stevenpi140/-/docs/acrylic/front-acrylic.png

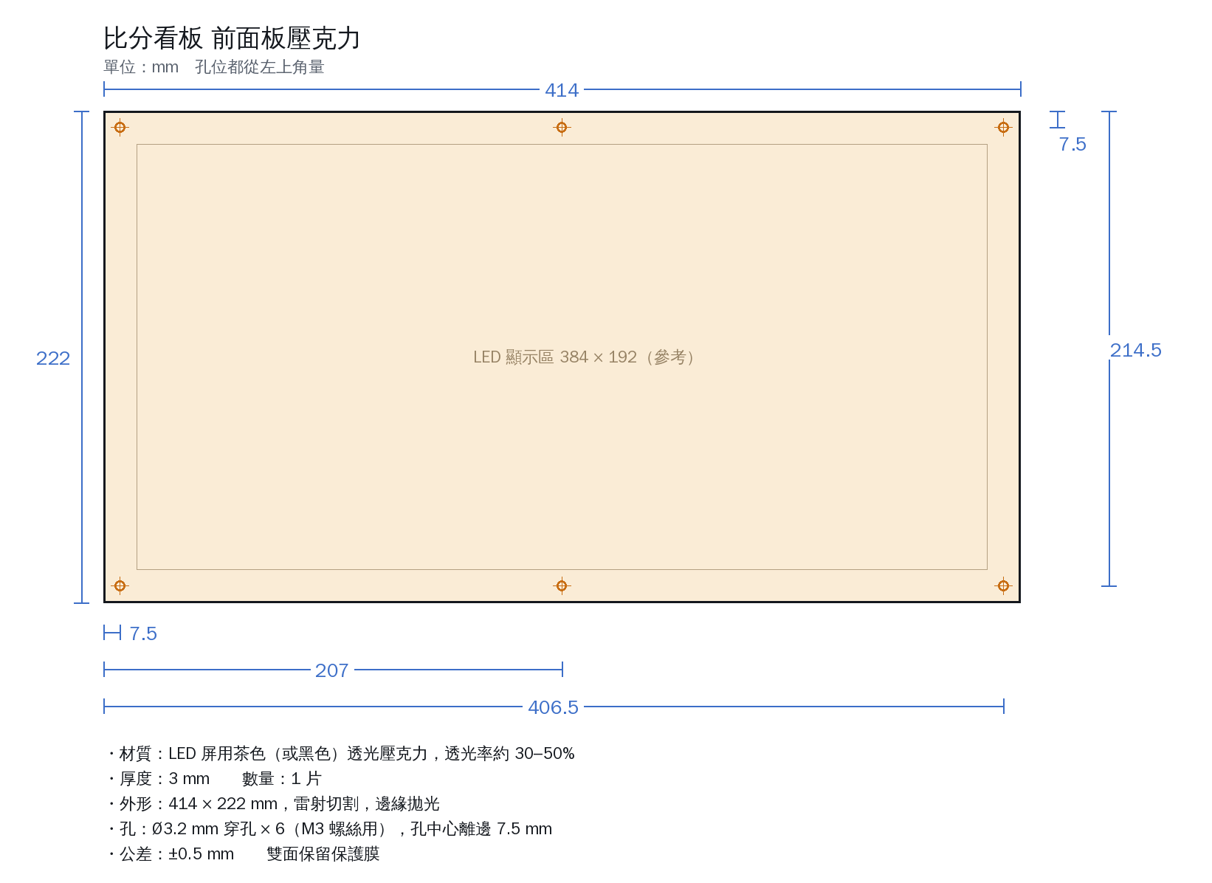
docs/acrylic/front-acrylic.png
