stevenpi140/-/(list of files, cad)

Other CAD files:
docs/acrylic/front-acrylic.dxf
