stevenpi140/-/firmware/include/es8311.h

// ES8311 音訊晶片驅動，取自微雪 ESP32-S3-RGB-Matrix 範例 09_Music_Player
// https://github.com/waveshareteam/ESP32-S3-RGB-Matrix （Apache License 2.0）
#pragma once

#include <Arduino.h>
#include <Wire.h>

#define ES8311_ADDR              0x18
#define ES8311_SAMPLE_RATE48     48000
#define ES8311_BITS_PER_SAMPLE16 16

struct coeff_div_t {
  uint32_t mclk;
  uint32_t rate;
  uint8_t pre_div;
  uint8_t pre_multi;
  uint8_t adc_div;
  uint8_t dac_div;
  uint8_t fs_mode;
  uint8_t lrck_h;
  uint8_t lrck_l;
  uint8_t bclk_div;
  uint8_t adc_osr;
  uint8_t dac_osr;
};

class ES8311 {
public:
  explicit ES8311(TwoWire *wire_instance = &Wire);
  ~ES8311();

  bool begin(int32_t sda, int32_t scl, uint32_t frequency);
  bool setVolume(uint8_t volume);
  uint8_t getVolume();
  bool setSampleRate(uint32_t sample_rate);
  bool setBitsPerSample(uint8_t bps);
  bool enableMicrophone(bool enable);
  bool setMicrophoneGain(uint8_t gain);
  uint8_t getMicrophoneGain();
  void read_all();

protected:
  int get_coeff(uint32_t mclk, uint32_t rate);
  bool WriteReg(uint8_t reg, uint8_t val);
  uint8_t ReadReg(uint8_t reg);

private:
  TwoWire *_wire = nullptr;
  uint32_t _mclk_hz = 48000 * 256;
};
