stevenpi140/-/(commit log)

2026-10-26 點陣比分看板：伺服器（五聯盟資料＋點陣渲染）與 ESP32 HUB75 韌體
    - server/: 抓取 CPBL、MLB、NBA、TPBL、PLG 今日賽事，依追蹤清單篩選，
    渲染成 128x64 RGB565 畫面給 ESP32；含預覽、probe 除錯指令與測試
    - firmware/: PlatformIO 專案（MatrixPortal S3 / 一般 ESP32），
    WiFiManager 設定、雙緩衝顯示、按鍵換頁／暫停
    - README: 硬體清單、接線、安裝與疑難排解
    Claude-Session: https://claude.ai/code/session_016gQEbBCiwzjvZz93CgmEKp
2026-10-26 硬體改推薦 ESP32 Trinity，韌體加入 trinity env 與單緩衝備援
    - 函式庫作者表示 MatrixPortal S3 搭配此函式庫可能有 WiFi 干擾，改推薦 Trinity
    - README 硬體清單補上查到的價格、面板驅動晶片相容清單、E 腳說明
    - 一般 ESP32 記憶體不足以雙緩衝時自動改單緩衝，並移除多餘的 16KB 畫面暫存
    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
2026-10-26 新增淘寶硬體組合：微雪 ESP32-S3-RGB-Matrix 驅動板與韌體 env
    - 韌體新增 waveshare_s3 env（ESP32-S3-WROOM-2 N32R16V，opi 記憶體設定），
    HUB75 腳位依微雪文件，E 腳 GPIO 9
    - README 加入淘寶可購買的組合、搜尋關鍵字與選購注意事項
    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
2026-10-26 依季節自動切換籃球／棒球，重疊期間全部輪播；確保每一場都輪到
    - config 新增 season（mode: auto/basketball/baseball/all 與日期區間），
    預設籃球季 10/1~6/30、棒球季 3/1~10/15，非當季聯盟不抓資料
    - 比賽固定依開打時間排序，總覽頁與單場頁穿插，每一圈每場都會出現
    - /api/status 顯示目前季節、頁數與輪播一圈秒數
    - 範例設定改為各聯盟預設全部顯示
    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
2026-10-26 移除季節切換：改為當天有比賽的聯盟才出現在輪播
    - 拿掉 season 設定與相關判斷，所有聯盟照常抓資料
    - 保留固定排序與總覽頁穿插，每一圈每場都會輪到
    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
2026-10-26 韌體加入 OTA 無線更新
    - ArduinoOTA（主機名 scoreboard.local，密碼由 platformio.ini [ota] 設定），
    更新時面板顯示進度條，失敗顯示原因
    - 新增 *_ota env 透過 WiFi 上傳；4MB 板改用 min_spiffs 分割表、
    微雪 S3 用 default_16MB 分割表，確保放得下兩份韌體
    - 關閉 WiFi 省電模式讓抓圖與 OTA 更穩定
    - README 補上無線更新步驟
    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
2026-10-26 新增前面板壓克力訂製圖（DXF 與 PNG）與產生腳本
    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
    [front-acrylic.dxf]
2026-10-26 README 加入磁吸掛牆方式
    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
2026-10-26 新增 GitHub Actions 測試環境與端對端伺服器測試
    - CI：伺服器單元測試、真實資料來源檢查（probe 並印出原始回應）、
    四種板子的韌體編譯
    - probe 會把每個 HTTP 回應原樣存到 probe/raw/，方便對照欄位
    - 新增 /frame、/api/status 等 HTTP 端點的端對端測試
    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
2026-10-26 修正 CI 發現的問題並加強資料來源診斷
    - 韌體：HUB75 函式庫在 PlatformIO 的名稱是 mrfaptastic/…
    - NBA：未開打時比分設為空值（ESPN 會給 0）
    - TPBL：用 API 的 is_live 欄位判斷比賽中
    - PLG：官網回 403 時明確回報錯誤，不再顯示成 0 場
    - probe 新增 --diagnose，測試中職官網與野球革命的備用網址
    - CI 多抓上週末的比賽，確認有比賽的日子也能解析
    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
2026-10-26 中職改用野球革命 Rebas 為主要來源，官網為備援
    - 新增 leagues/rebas.py：解析整季比賽 JSON（得分、每局、先發、場地、狀態），
    比賽中最多每 60 秒重抓一次
    - TPBL：有比分且開打超過 2.5 小時但狀態未更新時視為終場
    - probe 顯示原始狀態欄位；診斷會列出官網連結與 Rebas 賽季代碼統計
    - 新增 Rebas 與 TPBL 的解析測試
    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
2026-10-26 診斷：尋找 Rebas 季後賽賽季代碼、測試中職官網正常瀏覽流程
    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
2026-10-26 中職：自動從野球革命找出當天的賽季（例行賽、季後挑戰賽、台灣大賽）
    - 讀 /api/leagues/CPBL 的賽季清單，挑出日期涵蓋當天的賽季（快取 6 小時）
    - 清單抓不到時退回例行賽代碼；仍可用 rebas_seasons 手動指定
    - README 更新資料來源與 PLG 說明
    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
2026-10-26 中職季後賽顯示「台灣大賽G7」這類標籤（賽季標題＋場次）
    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
2026-10-26 延賽處理：TPBL 颱風延賽仍標 NOT_STARTED 時改判延賽；英文狀態代碼一律顯示「延賽」
    - TPBL：開打 2.5 小時後完全沒有比分就當作延賽（10/24 薔琵颱風兩場）
    - 延賽不顯示 0-0 比分（中職、TPBL）
    - 延賽狀態文字只在來源是中文時照用，POSTPONED 等英文代碼顯示「延賽」
    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
2026-10-27 比賽中每 2 秒更新比分，看板停在進行中的比賽時每 2 秒重抓畫面
    - poll.live_seconds 預設改為 2；各聯盟可用 leagues.<聯盟>.live_seconds 個別設定
    - 中職（野球革命整季資料約 500KB）最快 10 秒一次（min_live_seconds）
    - 伺服器回傳 X-Refresh-Ms：有進行中比賽的頁面要求看板每 2 秒重抓
    - 韌體：停留期間依 X-Refresh-Ms 重抓同一頁，只更新畫面、不換頁
    - 伺服器快取畫好的頁面，資料沒變就不重畫
    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
2026-10-27 診斷：完整測試中職官網的頁面與網頁背後的資料網址
    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
2026-10-27 診斷：檢查中職官網首頁是否直接帶有比賽資料
    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
2026-10-27 中職改用官網為主要來源、野球革命備援；棒球加入安打與失誤（RHE）
    - 官網：賽程用 /schedule/getgamedatas，開打後用 /box/getlive 更新狀態、比分、RHE、局數、
    出局數、壘包（取自 LiveLogJson）；已結束比賽的單場資料快取起來不再重抓
    - 修正官網狀態判斷：賽程介面沒有 GameStatus，PresentStatus 不能當狀態用
    （10/17 台灣大賽 G1 已結束 0:3 被判成未開打）；改看結束時間、比賽結果、保留比賽欄位
    - 官網抓不到（例如伺服器不在台灣、被 HiNet CDN 擋）時自動改用野球革命
    - MLB（linescore.teams）、野球革命（hits/errors）、官網（Scoreboard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
2026-10-27 README 標題加上專案名稱 BallLED
    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
2026-10-27 更新 README 預覽圖：加入 RHE、台灣大賽標籤、中職終場與 TPBL，並附上產生腳本
    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
2026-10-27 總覽頁對齊：比分的「-」與時間的「:」固定在同一欄，主隊名稱靠右對齊
    - 每一頁共用同一個比分中心與主隊右緣，不再依每列隊名長度各自置中
    - 放不下時先拿掉終場的「終」；延賽的「延」不再重複顯示
    - 真的放不下（三位數比分加三字隊名的比賽中）才退回每列各自置中
    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
2026-10-28 整點報時：平日 09-20 點、假日 12-20 點整點用驅動板喇叭播放音檔
    - 伺服器：chime.py 依 config.yaml 的時段（含國定假日、補班日）計算下一次報時，
    每次畫面回應帶 X-Chime-In/Id/Ver/Volume；/chime.pcm 提供轉好的 48kHz 單聲道 PCM（ffmpeg 轉檔）；
    POST /api/chime/test 可以馬上測試
    - 韌體：微雪 ESP32-S3-RGB-Matrix 的 ES8311（I2C 47/48）＋ I2S（MCLK 12、BCLK 43、LRC 38、DOUT 21）
    ＋功放 GPIO 11，腳位與 ES8311 驅動取自微雪官方範例（Apache-2.0）；音檔存在 PSRAM，背景工作播放
    - 微雪板子比照官方範例預設啟用 FM6126A 面板驅動設定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
2026-10-29 更新 README 預覽圖；Windows／macOS 可以把 wqy-zenhei.ttc 放在 server/fonts/ 直接使用
    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
2026-10-29 開機後 2 秒內按住 BOOT 才清除 WiFi 設定（接電前按著會進入燒錄模式，原本的做法不會生效）
    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
2026-10-29 README：依微雪官方配置清單更新面板配件（附 4 顆磁吸螺絲）
    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
